tyretoff/shag_dv_Gyver_WEB/20240512_233047.jpg

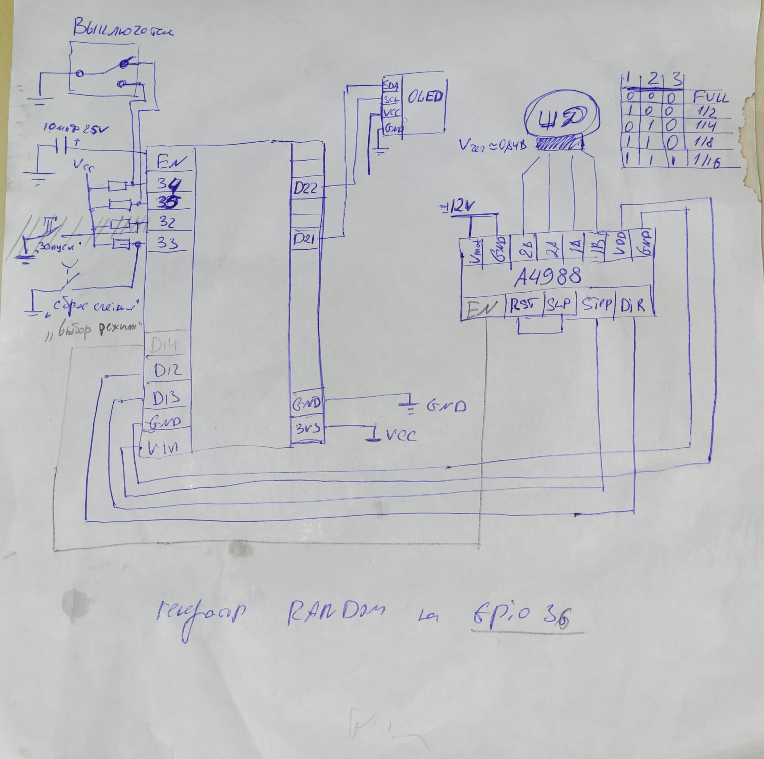
20240512_233047.jpg
