tyretoff/shag_dv_Gyver_WEB/20240515_084714.jpg

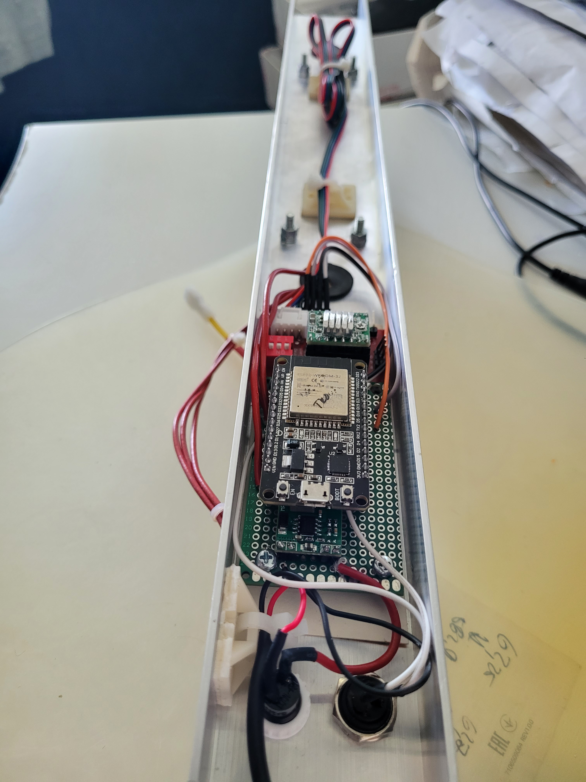
20240515_084714.jpg
