tyretoff/shag_dv_Gyver_WEB/20240515_084741.jpg

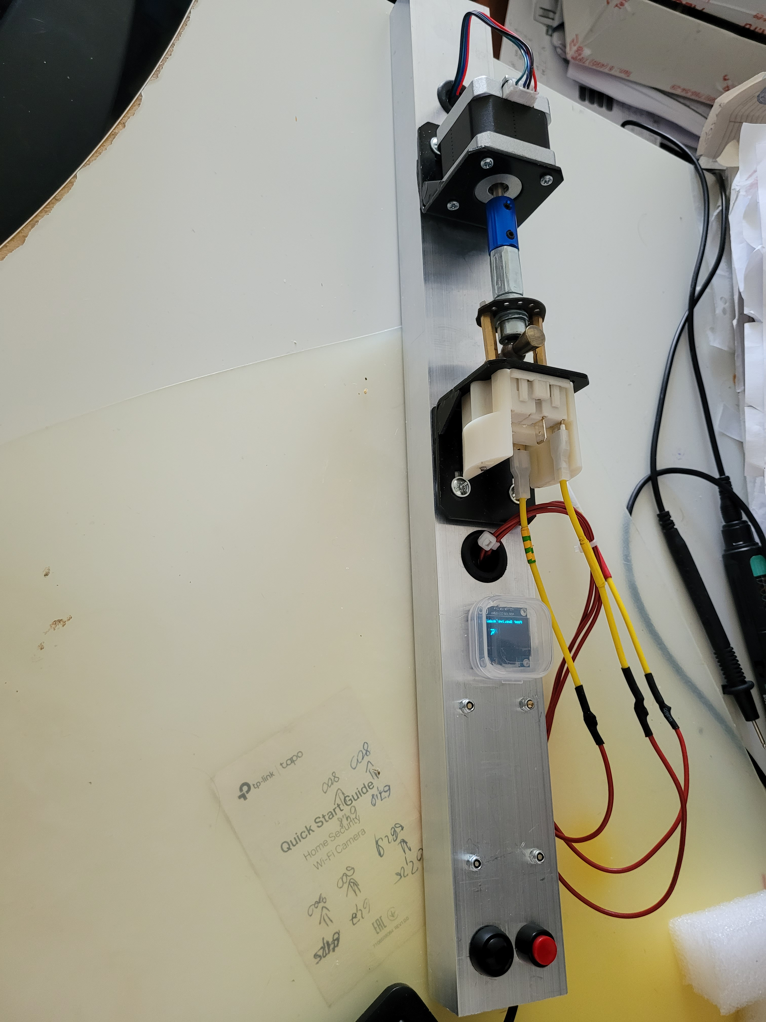
20240515_084741.jpg
