tyretoff/shag_dv_Gyver_WEB/5420271134852640150.jpg

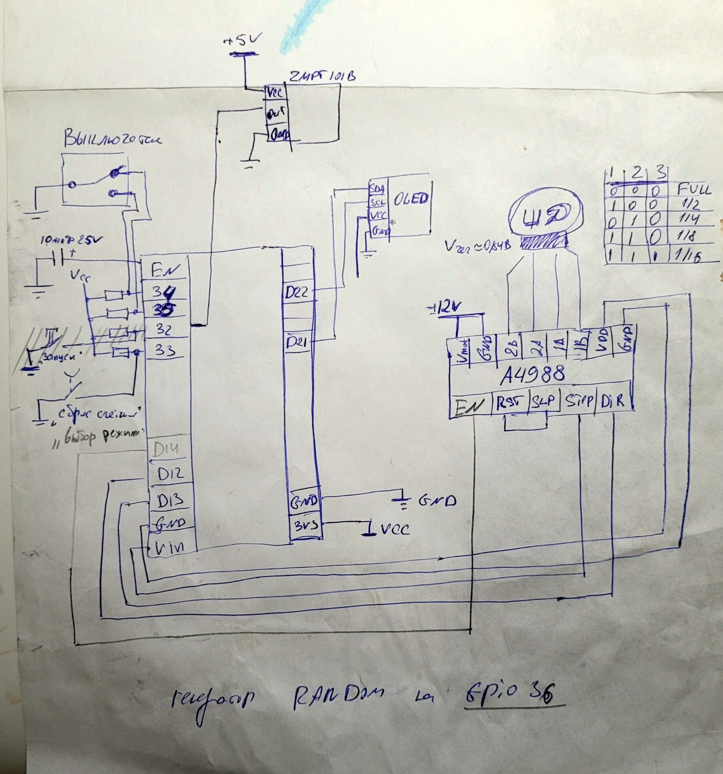
5420271134852640150.jpg
