tyretoff/shag_dv_Gyver_WEB/(commit log)

2024-05-12 работает
2024-05-13 Добавлено отключение двигателя в паузах (stepper.enable(); / stepper.disable();)
2024-12-16 Пауза на считывание состояния выключателя
2024-12-18 пауза между переключениями, min max, сек изменена с4..8 на 2..5
2024-12-21 В схему на картинке добавлен датчик ZMPT101B
    Добавлена библиотека для работы с ним
2024-12-21 В код добавлен датчик напряжения ZMPT
    изменена логика выбора режима:
    1 клик - В1, В2
    2 клика В1 прох
    3 клика тестирование с помощью датчика напряжения
    Hold - пауза/сброс счетчика
