tyretoff/shag_dv_Gyver_WEB/(notices)

Notices in the files:
README.md:
License: MIT
